QiHuiKeJi/Deng-s-foc-controller/灯哥开源FOC专用 Arduino 编程环境/readme.txt

配置说明
"to Program Files" 文件夹中的内容复制到 C:\Program Files (x86)
"to Documents" 文件夹中的内容复制到 C:\Users\你的电脑用户名\Documents\Arduino
"to Local"文件夹中的内容复制到 C:\Users\你的电脑用户名\AppData\Local

完成这三步后，点击 C:\Program Files (x86)\Arduino 中的 arduino.exe 即可打开软件，开始编译例程，愉快的玩耍
