QiHuiKeJi/Deng-s-foc-controller/Dengs FOC V1.0 DIY资料/BOM物料表/BOM.csv

ID | Name | Designator | Footprint | Quantity | Manufacturer Part | Manufacturer | Supplier | Supplier Part | _Price | LCSC Assembly
1 | 4.7K | R11,R4,R13,R12,R5,R6 | R0603 | 6 | 0603WAF4701T5E | UniOhm | LCSC | C23162 |  | Yes
2 | HDR-F-2.54_1x2 | H5,H1,H6 | HDR-F-2.54_1X2 | 3 |  |  | LCSC | C49661
3 | WJ128V-5.0-2P | P1 | CONN-TH_2P-P5.00_WJ128V-5.0-2P | 1 | WJ128V-5.0-2P | ReliaPro | LCSC | C8269
4 | LBAT54SLT1G | D1 | SOT-23_L2.9-W1.3-P0.95-LS2.4-BR | 1 | LBAT54SLT1G | LRC | LCSC | C12765 |  | Yes
5 | 10nF | C2 | C0805 | 1 | CL21A106KAYNNNE | SAMSUNG | LCSC | C15850 |  | Yes
6 | 1K | R2 | R0805 | 1 | 0805W8F1001T5E | UniOhm | LCSC | C17513 |  | Yes
7 | HDR-F-2.54_1x5 | H4,H8 | HDR-F-2.54_1X5 | 2 |  |  | LCSC | C50950
8 | L6234PD013TR | U2,U1 | POWERSO20_L15.9-W11.0-P1.27-LS14.2-BL-EP | 2 | L6234PD013TR | STMicroelectronics | LCSC | C77581
9 | M1_OUT | P2 | CONN-TH_3P-P5.00_WJ128V-5.0-3P | 1 | WJ128V-5.0-3P | ReliaPro | LCSC | C8270
10 | M2_OUT | P3 | CONN-TH_3P-P5.00_WJ128V-5.0-3P | 1 | WJ128V-5.0-3P | ReliaPro | LCSC | C8270
11 | 220nF | C1 | C0805 | 1 | CL21B224KBFNNNE | SAMSUNG | LCSC | C5378 |  | Yes
12 | HX25003-2WAP | CN1 | CONN-TH_2P-P2.50_HX25003-2WAP | 1 | HX25003-2WAP | HX(Zhejiang Yueqing Hongxing Elec) | LCSC | C442326
13 | 4.7K | R1,R3 | R0805 | 2 | RMC08054.7K5%N | Tyohm | LCSC | C269733
14 | 17-21SUYC/TR8 | LED1 | LED0805-RD | 1 | 17-21SUYC/TR8 | KENTO | LCSC | C2296 |  | Yes
15 | micropython esp32 | U3 | MICROPYTHON ESP32 | 1
16 | 100uF | C8 | CAP-SMD_BD6.3-L6.6-W6.6-FD | 1 | RVE1V101M0607 | ROQANG | LCSC | C99837
17 | 1uF | C5,C6 | C0805 | 2 | CL21B105KBFNNNE | SAMSUNG | LCSC | C28323 |  | Yes
18 | PWM_2 | H3 | HDR-F-2.54_1X4 | 1 |  |  | LCSC | C225501
19 | PWM_1 | H2 | HDR-F-2.54_1X4 | 1 |  |  | LCSC | C225501
20 | 100nF | C7 | C0805 | 1 | CL21B103KBANNNC | SAMSUNG | LCSC | C1710 |  | Yes
