QiHuiKeJi/Deng-s-foc-controller/Dengs FOC V1.0 测试例程/3 AS5600双编码器测试/3_dual_as5600_test/3_dual_as5600_test.ino

#include <SimpleFOC.h>

/** Annoyingly some i2c sensors (e.g. AS5600) have a fixed chip address.  This means only one of these devices can be addressed on a single bus
 * This example shows how a second i2c bus can be used to communicate with a second sensor.  
 */ 

MagneticSensorI2C sensor0 = MagneticSensorI2C(AS5600_I2C);
MagneticSensorI2C sensor1 = MagneticSensorI2C(AS5600_I2C);
TwoWire I2Cone = TwoWire(0);
TwoWire I2Ctwo = TwoWire(1);


void setup() {

  Serial.begin(115200);
  _delay(750);

  I2Cone.begin(18, 5, 400000); 
  I2Ctwo.begin(19, 23, 400000);
  sensor0.init(&I2Cone);
  sensor1.init(&I2Ctwo);
}

void loop() {
  _delay(200);
  Serial.print(sensor0.getAngle()); 
  Serial.print(" - "); 
  Serial.print(sensor1.getAngle());
  Serial.println();
}
