QiHuiKeJi/Deng-s-foc-controller/Test Sample/1 磁编码器--iic方式--测试例程/magnetic_sensor_i2c_example.ino

#include <SimpleFOC.h>

// MagneticSensorI2C(uint8_t _chip_address, float _cpr, uint8_t _angle_register_msb)
//  chip_address  I2C chip address
//  bit_resolution  resolution of the sensor
//  angle_register_msb  angle read register msb
//  bits_used_msb  number of used bits in msb register
// 
// make sure to read the chip address and the chip angle register msb value from the datasheet
// also in most cases you will need external pull-ups on SDA and SCL lines!!!!!
//
// For AS5058B use MagneticSensorI2C(0x40, 14, 0xFE, 8)
// Example of AS5600 configuration 
MagneticSensorI2C sensor = MagneticSensorI2C(0x36, 12, 0x0E, 4);
MagneticSensorI2C sensor1 = MagneticSensorI2C(0x36, 12, 0x0E, 4);

void setup() {
  // monitoring port
  Serial.begin(115200);
  //sensor 1
  sensor.sda_pin = 4;
  sensor.scl_pin =0;
  sensor.init();
  //sensor 2
  sensor1.sda_pin = 19;
  sensor1.scl_pin = 23; 
  // initialise magnetic sensor hardware
  sensor1.init();

  Serial.println("Sensor ready");
  _delay(1000);
}

void loop() {
  // display the angle and the angular velocity to the terminal
  Serial.println("Sensor 1");
  Serial.print(sensor.getAngle());
  Serial.print("\t");
  
  //Serial.println("Sensor 2");
  //Serial.print(sensor1.getAngle());
  //Serial.print("\t");
  //Serial.println(sensor.getVelocity());
}
