QiHuiKeJi/Deng-s-foc-controller/(commit log)

2021-02-17 add data
    [BOM.csv]
2021-03-06 update example
    [BOM.csv]
2021-03-06 update folder
    [BOM.csv]
2021-03-07 update arduino enviroment
2021-03-14 Create 灯哥开源FOC V1.0使用文档.pdf
